Luchangling/T100/(list of files, cad)

Other CAD files:
dtu_app/doc/原理图/PCB外形图.dwg
