Luchangling/T100/dtu_app/doc/原理图/T103.pdf

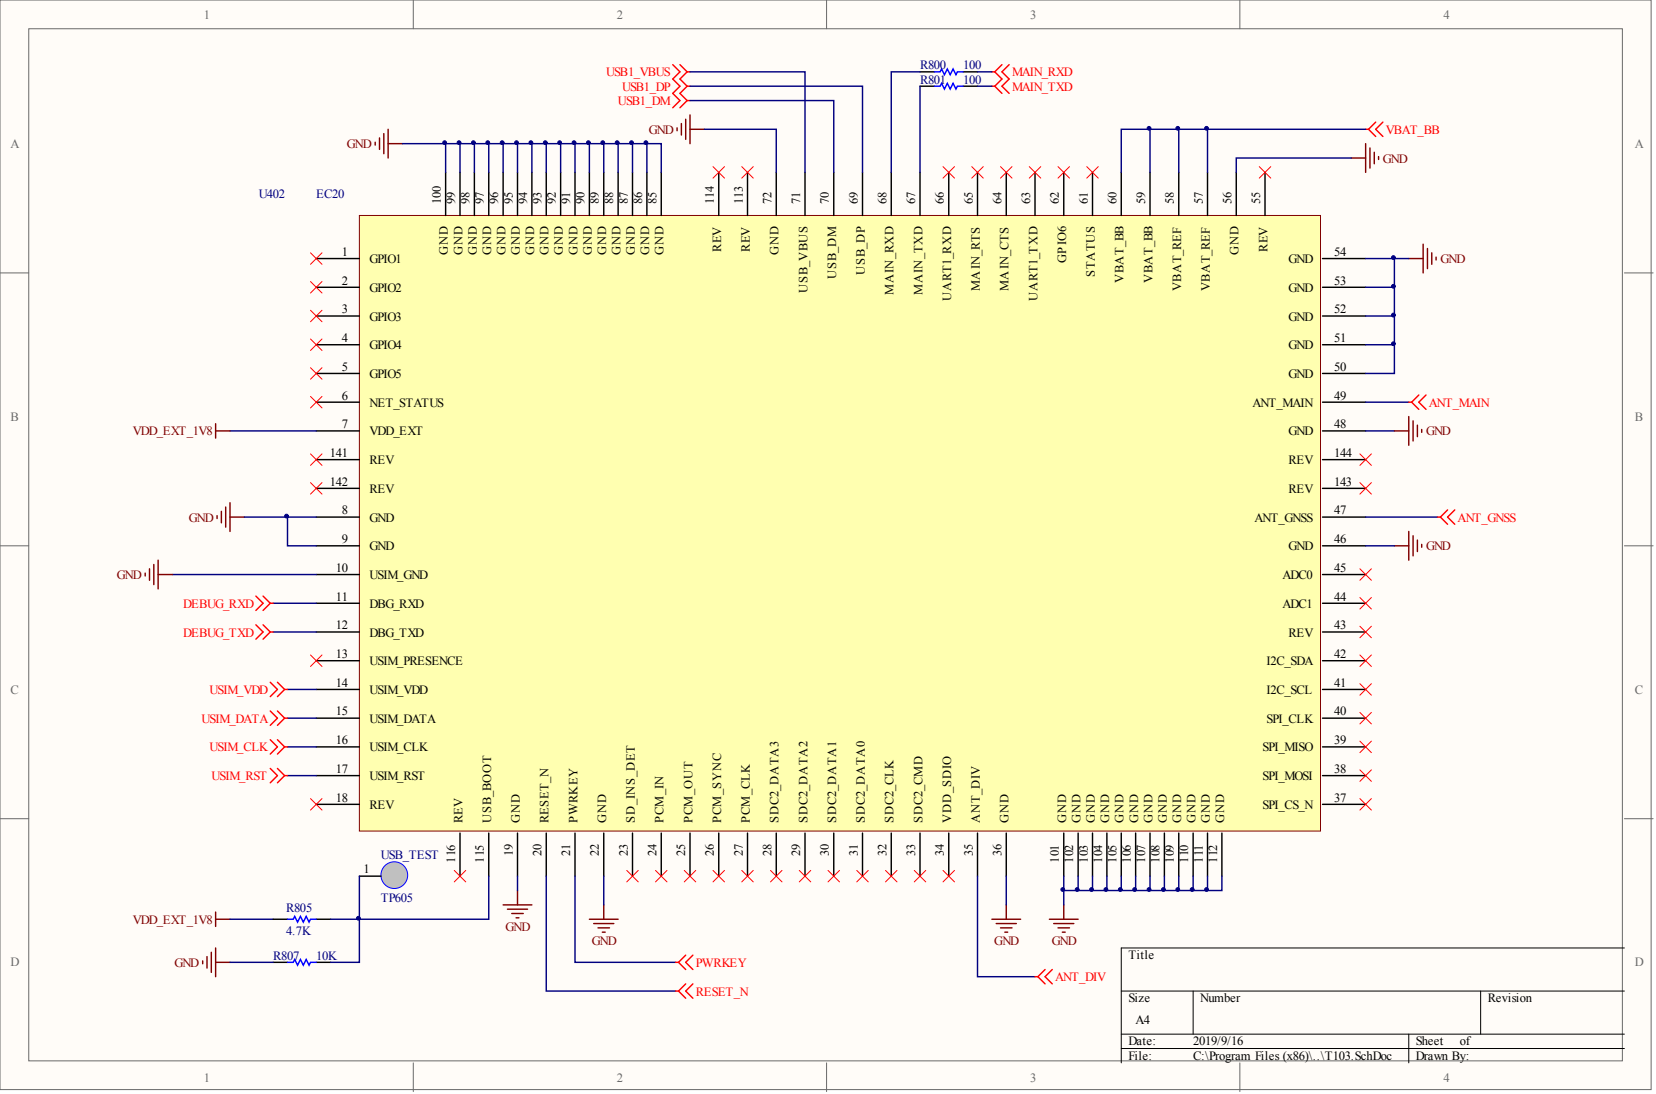
[picture p1: page 1]

GND 85 GND 86 GND 87 GND 88 GND 89 GND 90 GND 91 GND 92 GND 93 GND 94 GND 95 GND 96 GND 97 GND 98 GND 99 GND 100
