Luchangling/T100/dtu_app/doc/T100_V1.1_1128.pdf

A

1 | 2 | 3 | 4 | 5 | 6

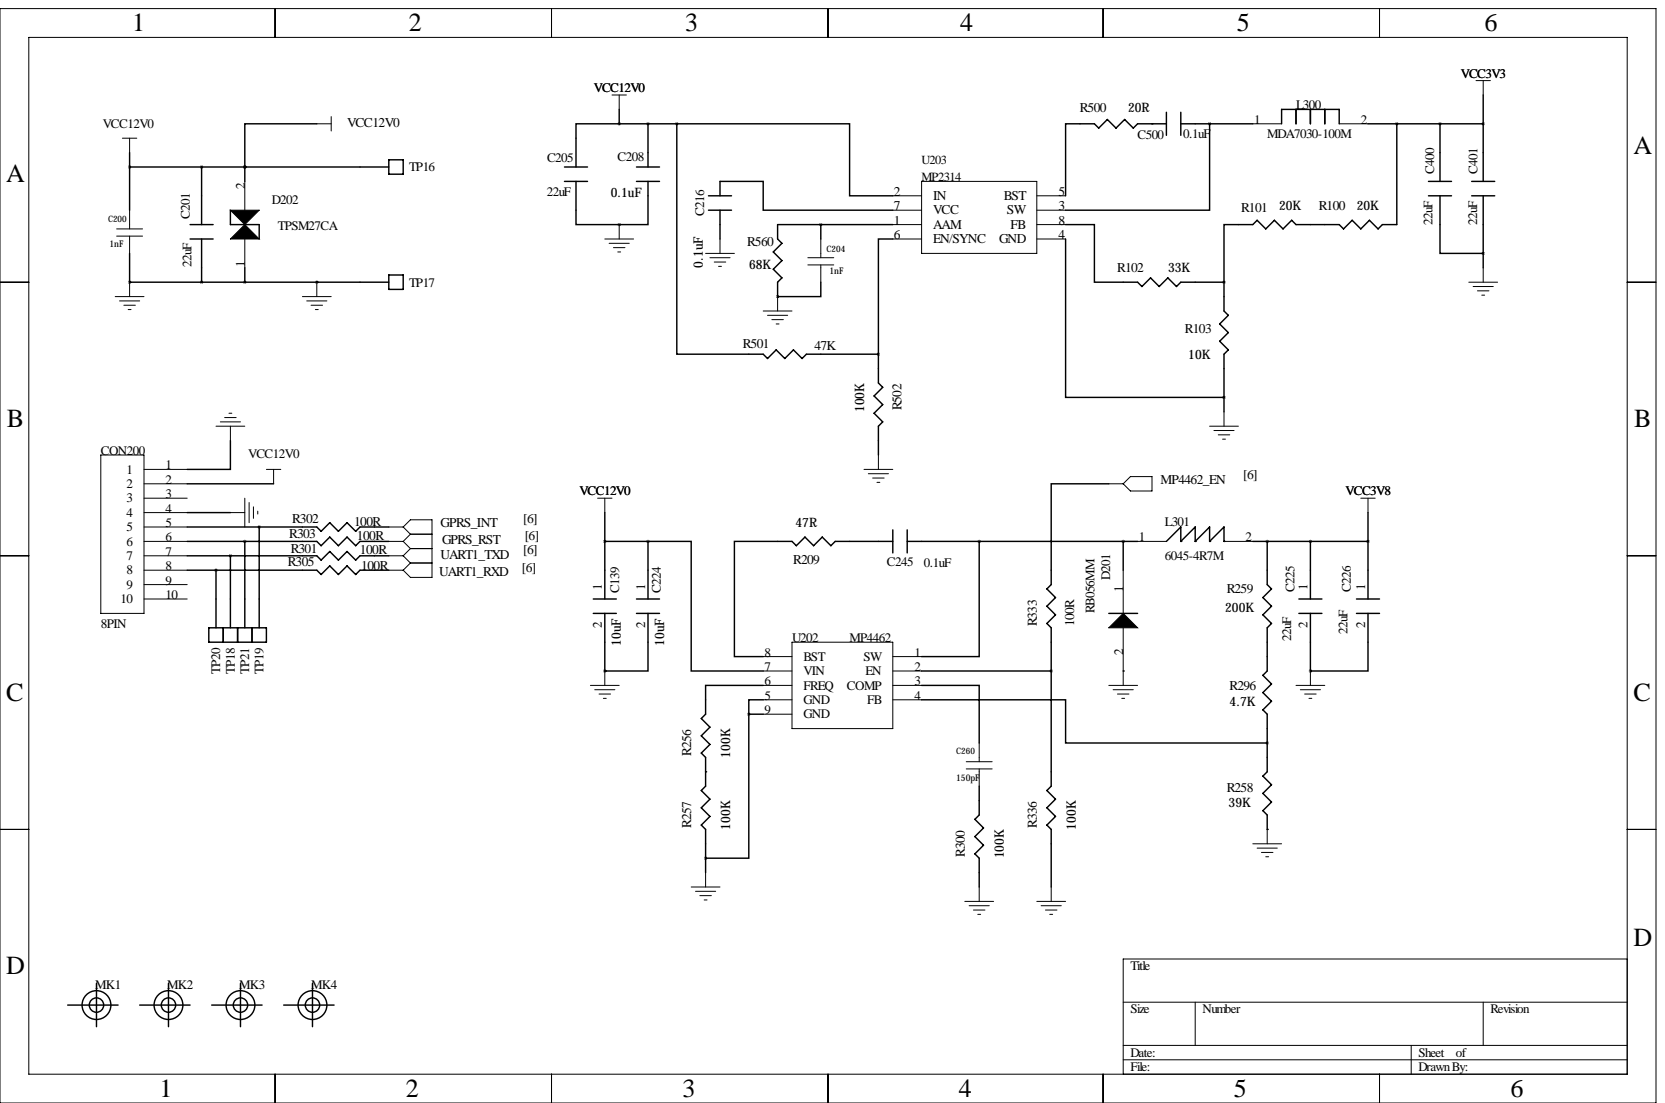
[picture p2: page 1]

Size | Number | Revision

Date: | Sheet of
File: | Drawn By:

A

A

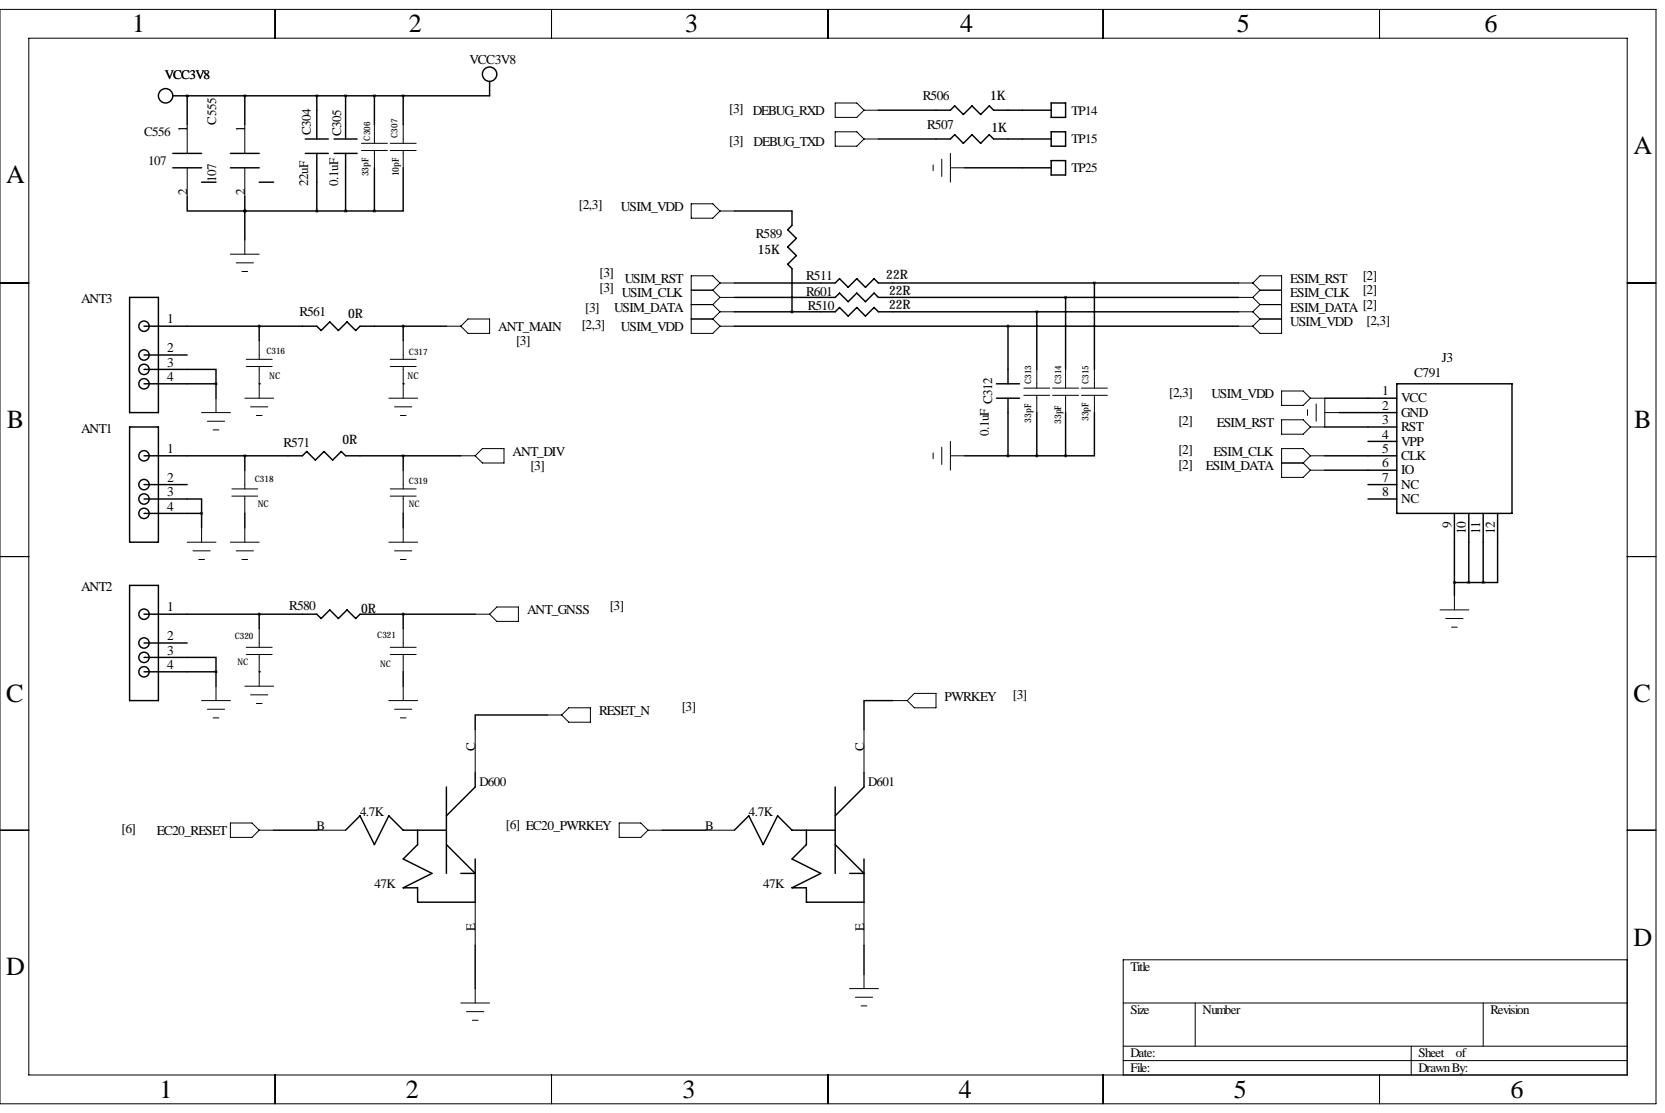
[picture p3: page 2]

Size | Number | Revision

Date: | Sheet of

A

A

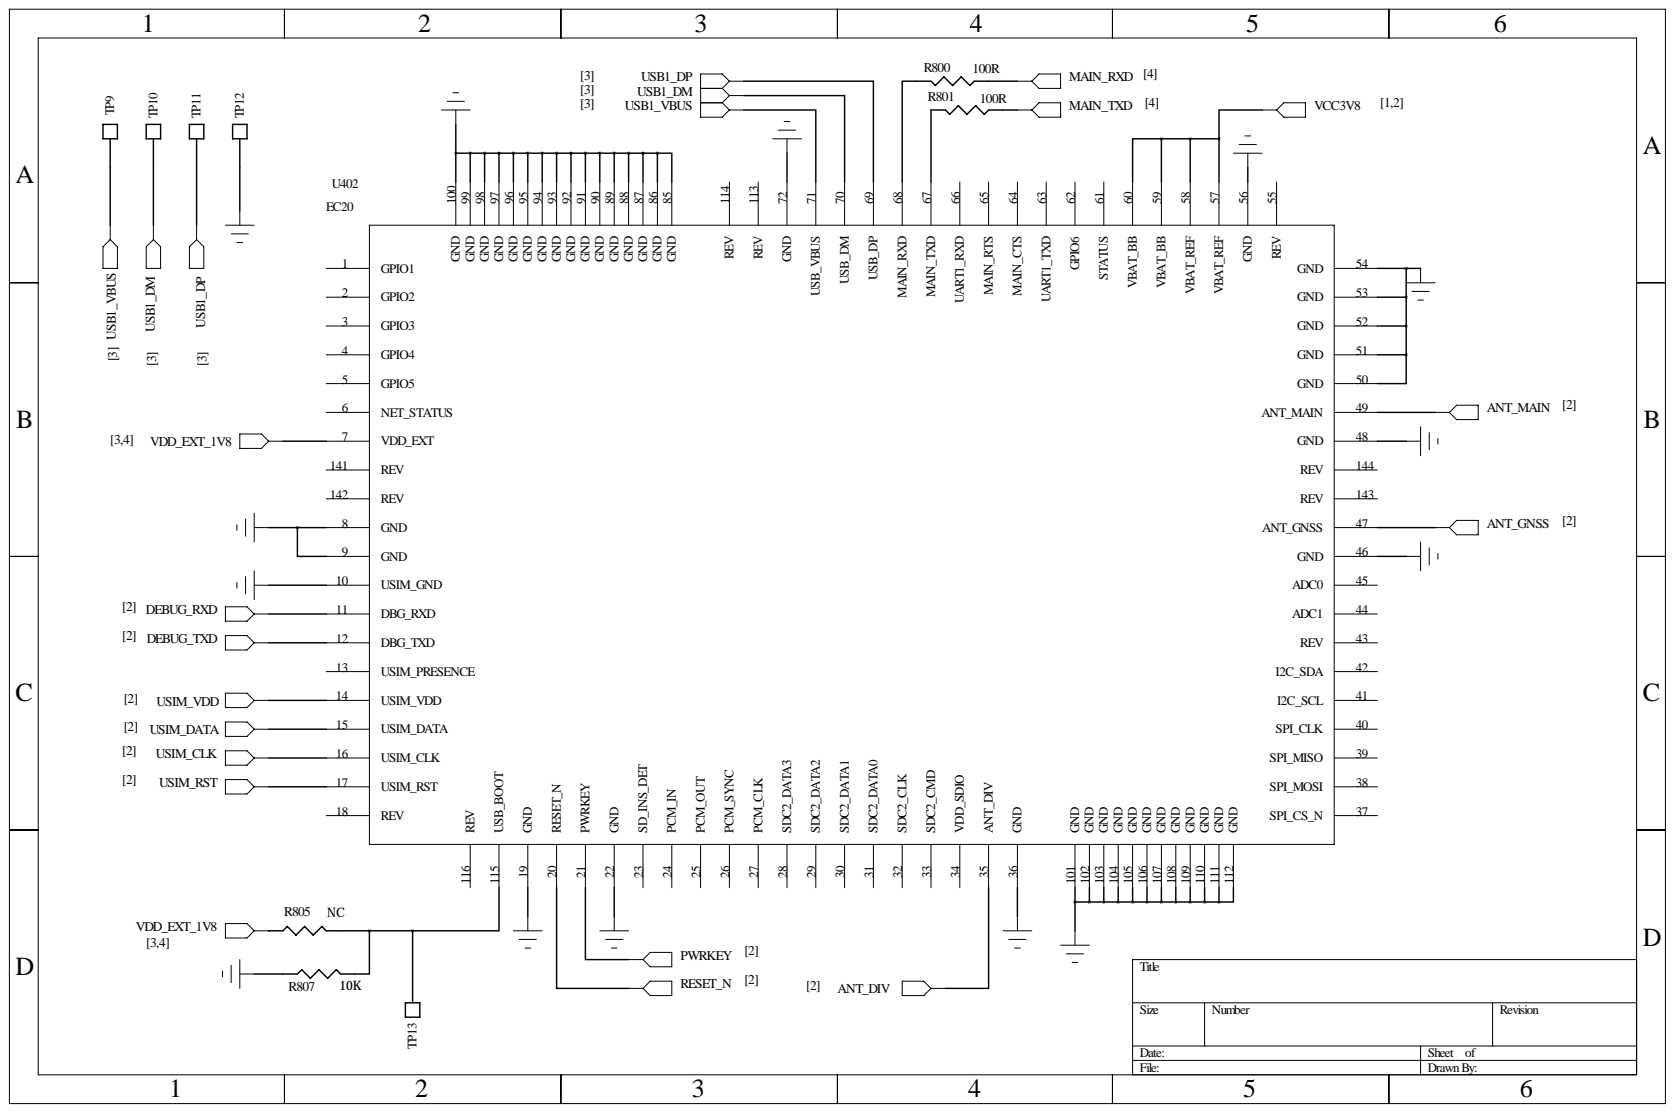
[picture p4: page 3]

Size | Number | Revision

Date: | Sheet of
File: | Drawn By:

A

A

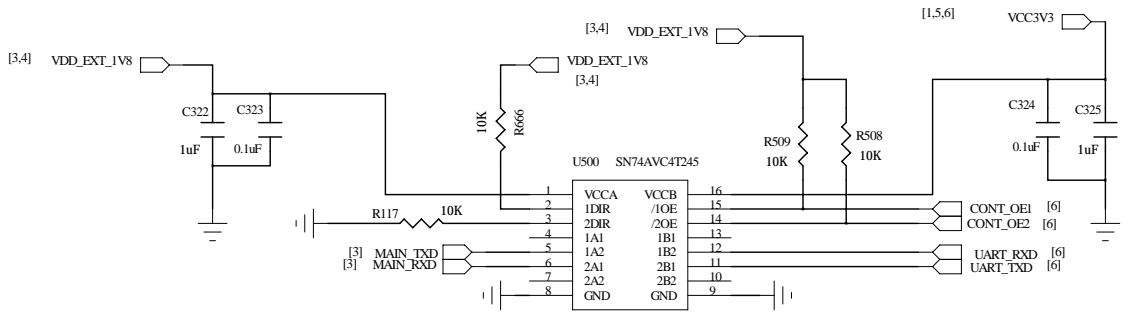
[picture p5: page 4]

Size | Number | Revision

Date: | Sheet of

A

A

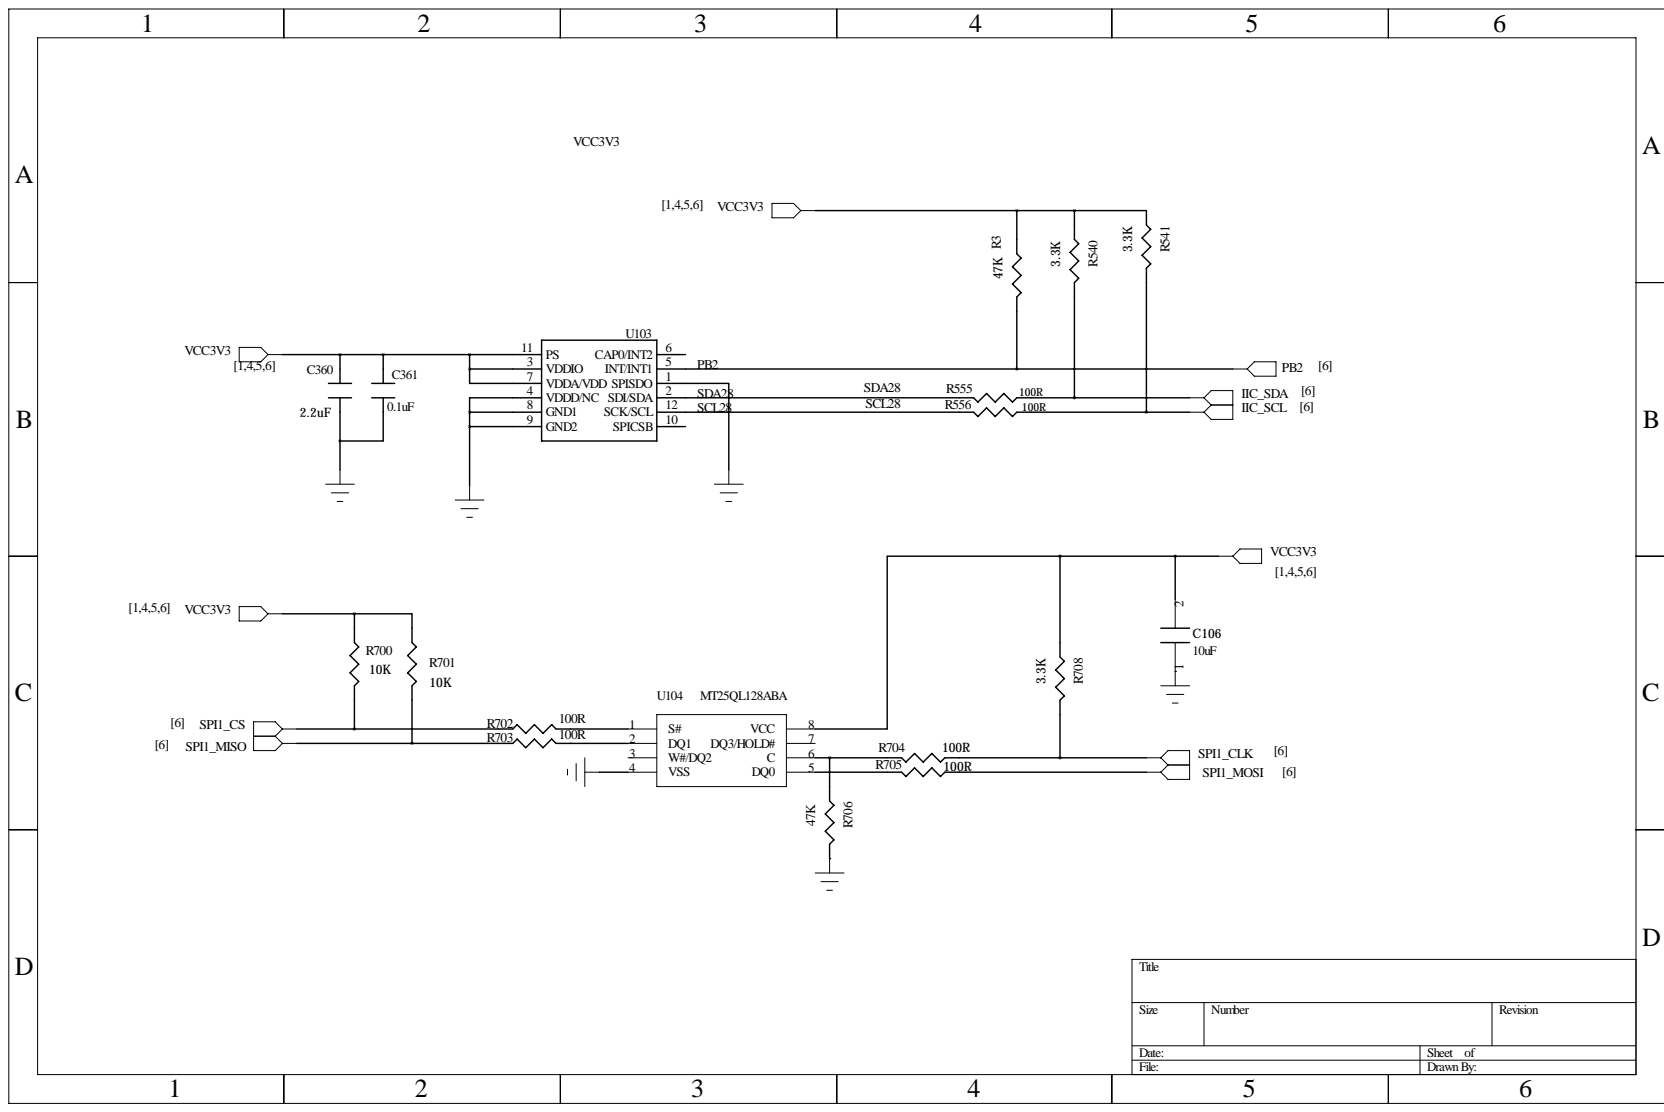
[picture p6: page 5]

Size | Number | Revision

Date: | Sheet of

A

A

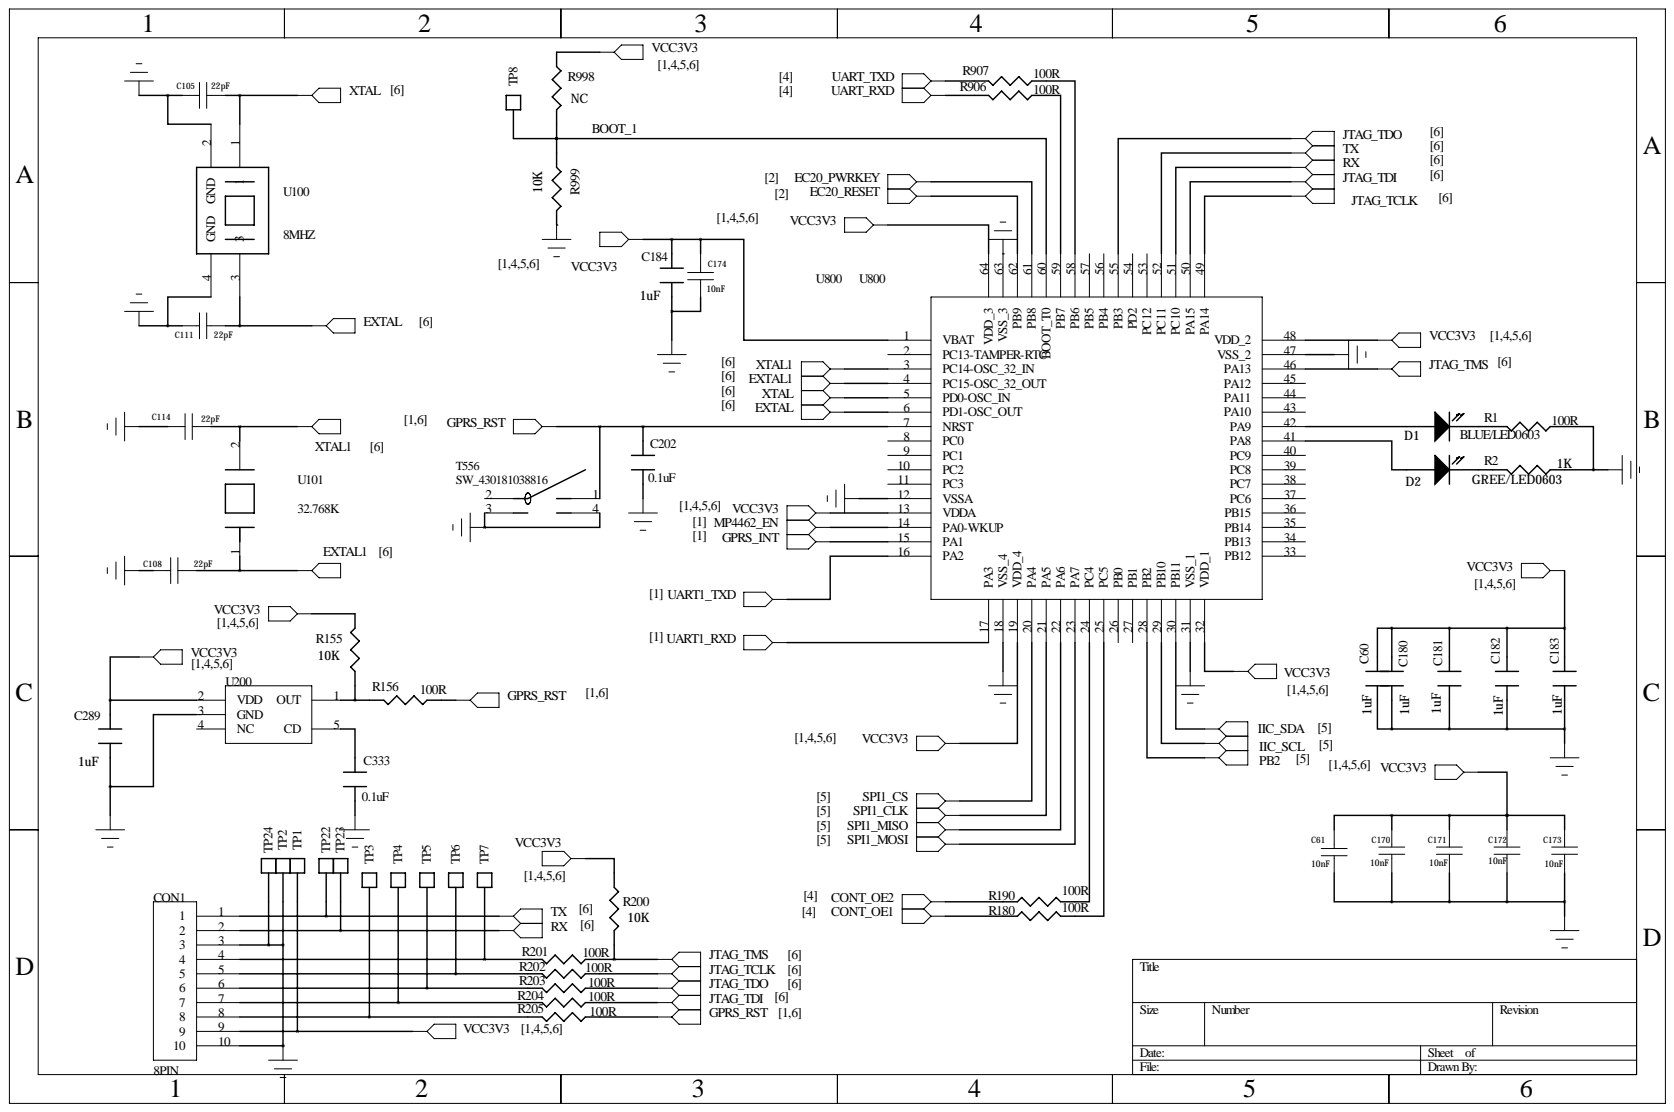
[picture p7: page 6]

Size | Number | Revision

Date: | Sheet of
