Luchangling/T100/dtu_app/doc/原理图/T101.pdf

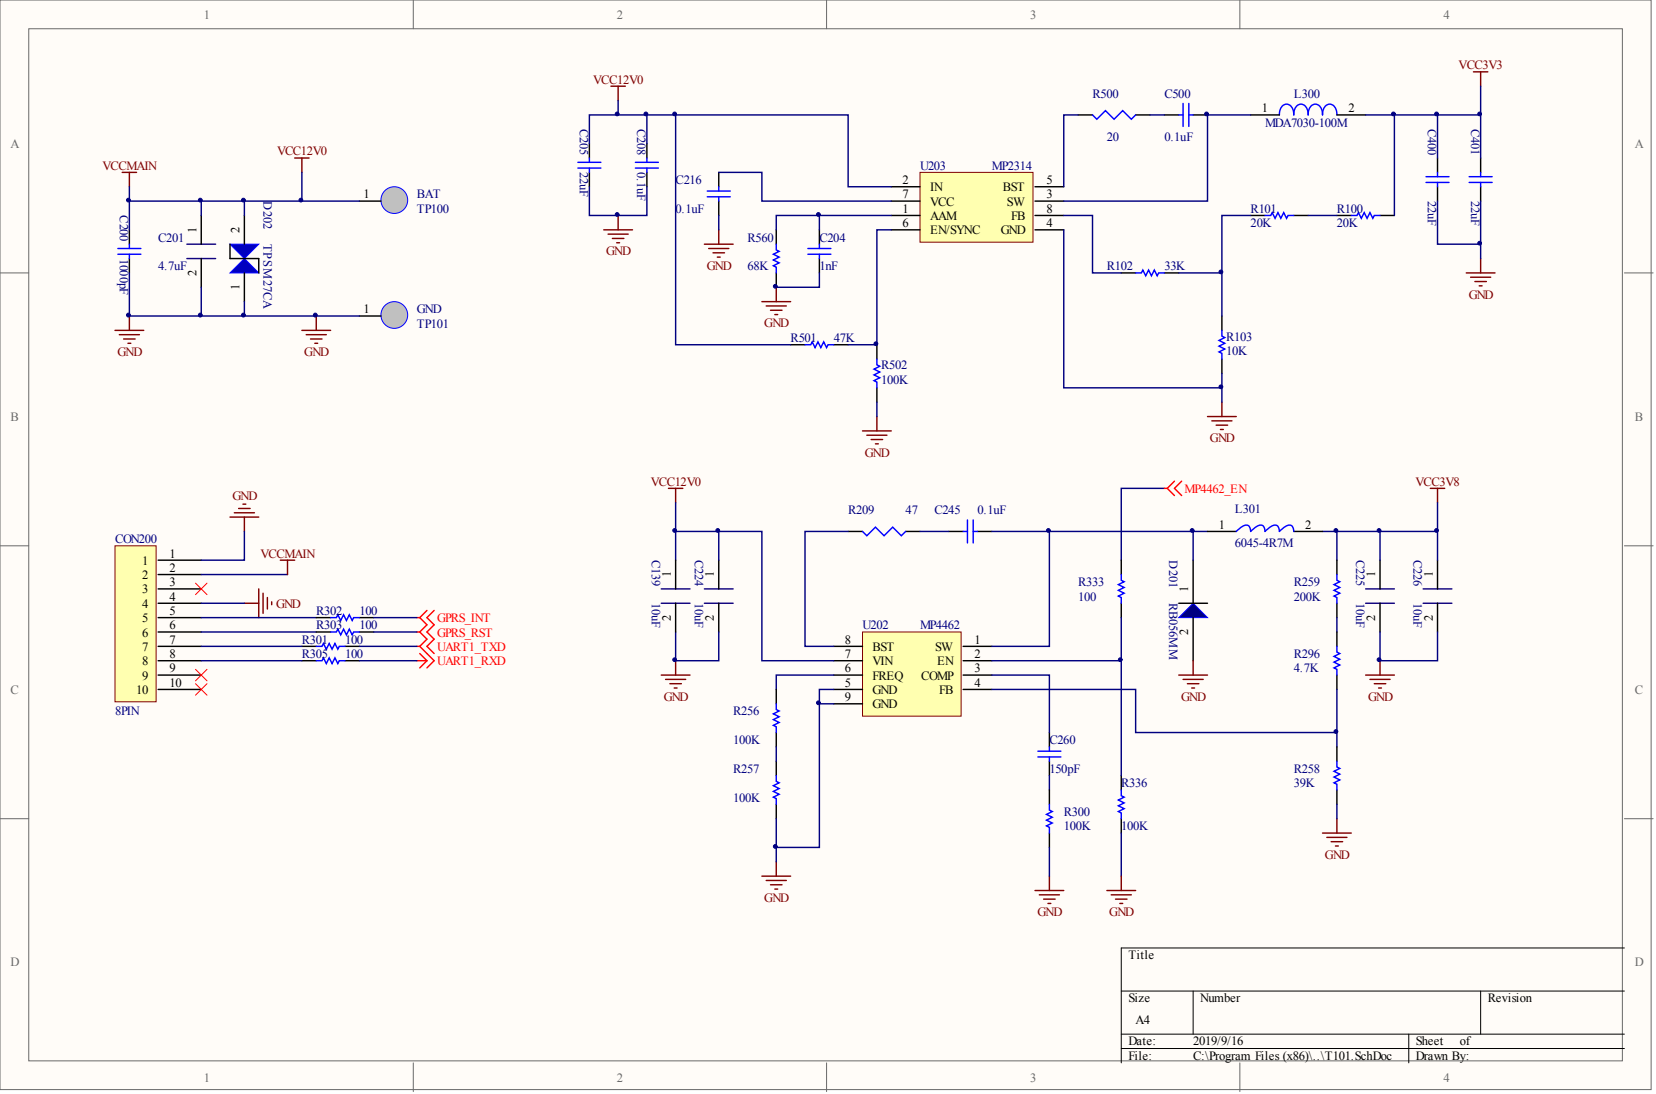
[picture p8: page 1]

VCC 7

EN/SYNC 6
