Luchangling/T100/dtu_app/doc/原理图/T102.pdf

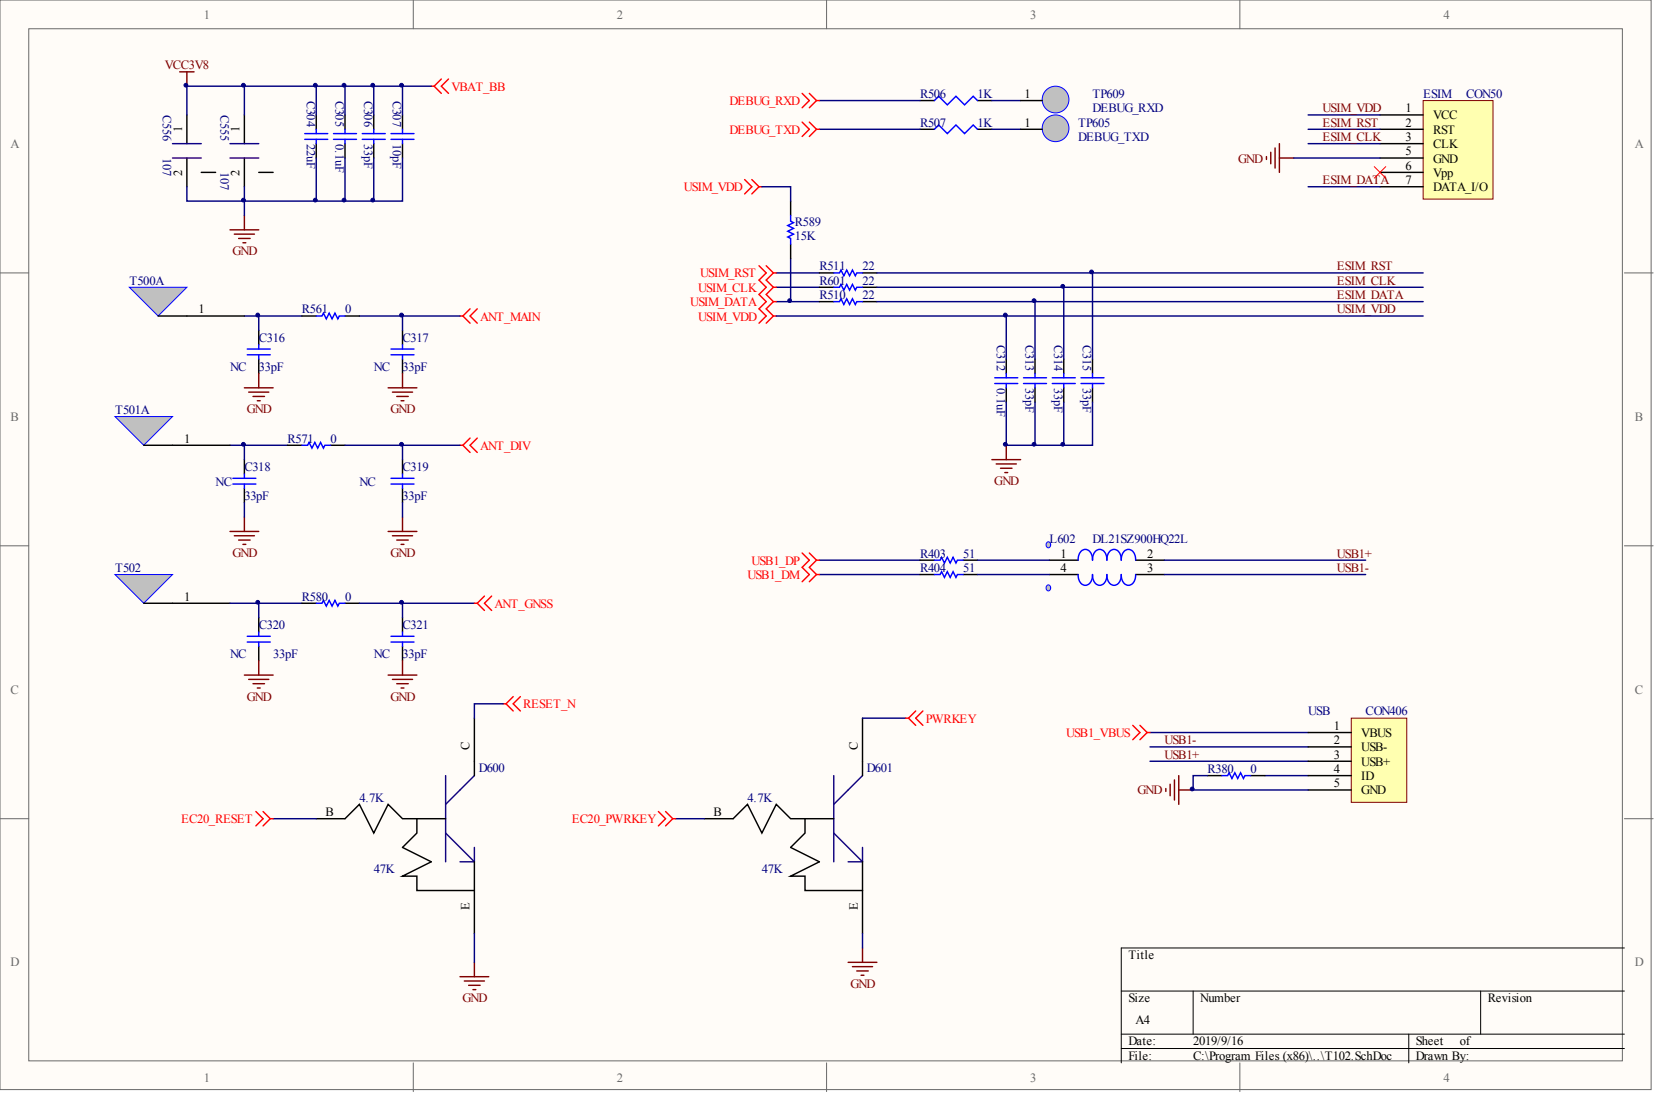
[picture p9: page 1]
