Luchangling/T100/dtu_app/doc/原理图/T104.pdf

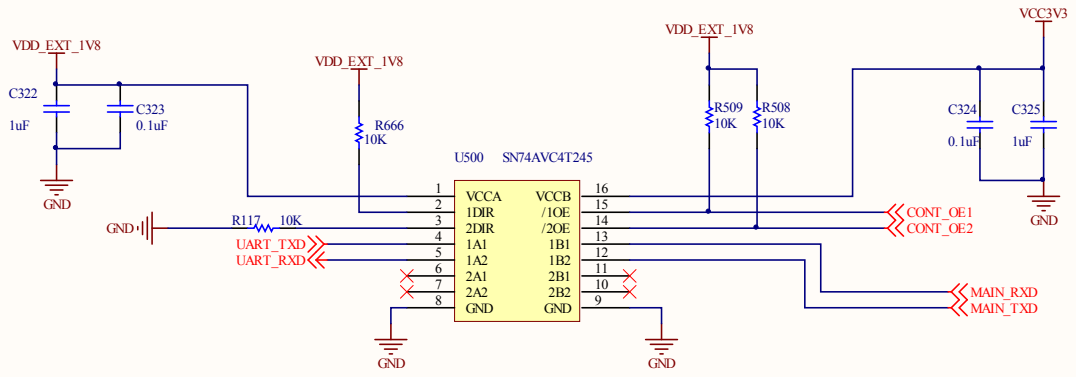
[picture p10: page 1]

1 2
1 1
