Luchangling/T100/dtu_app/doc/原理图/T105.pdf

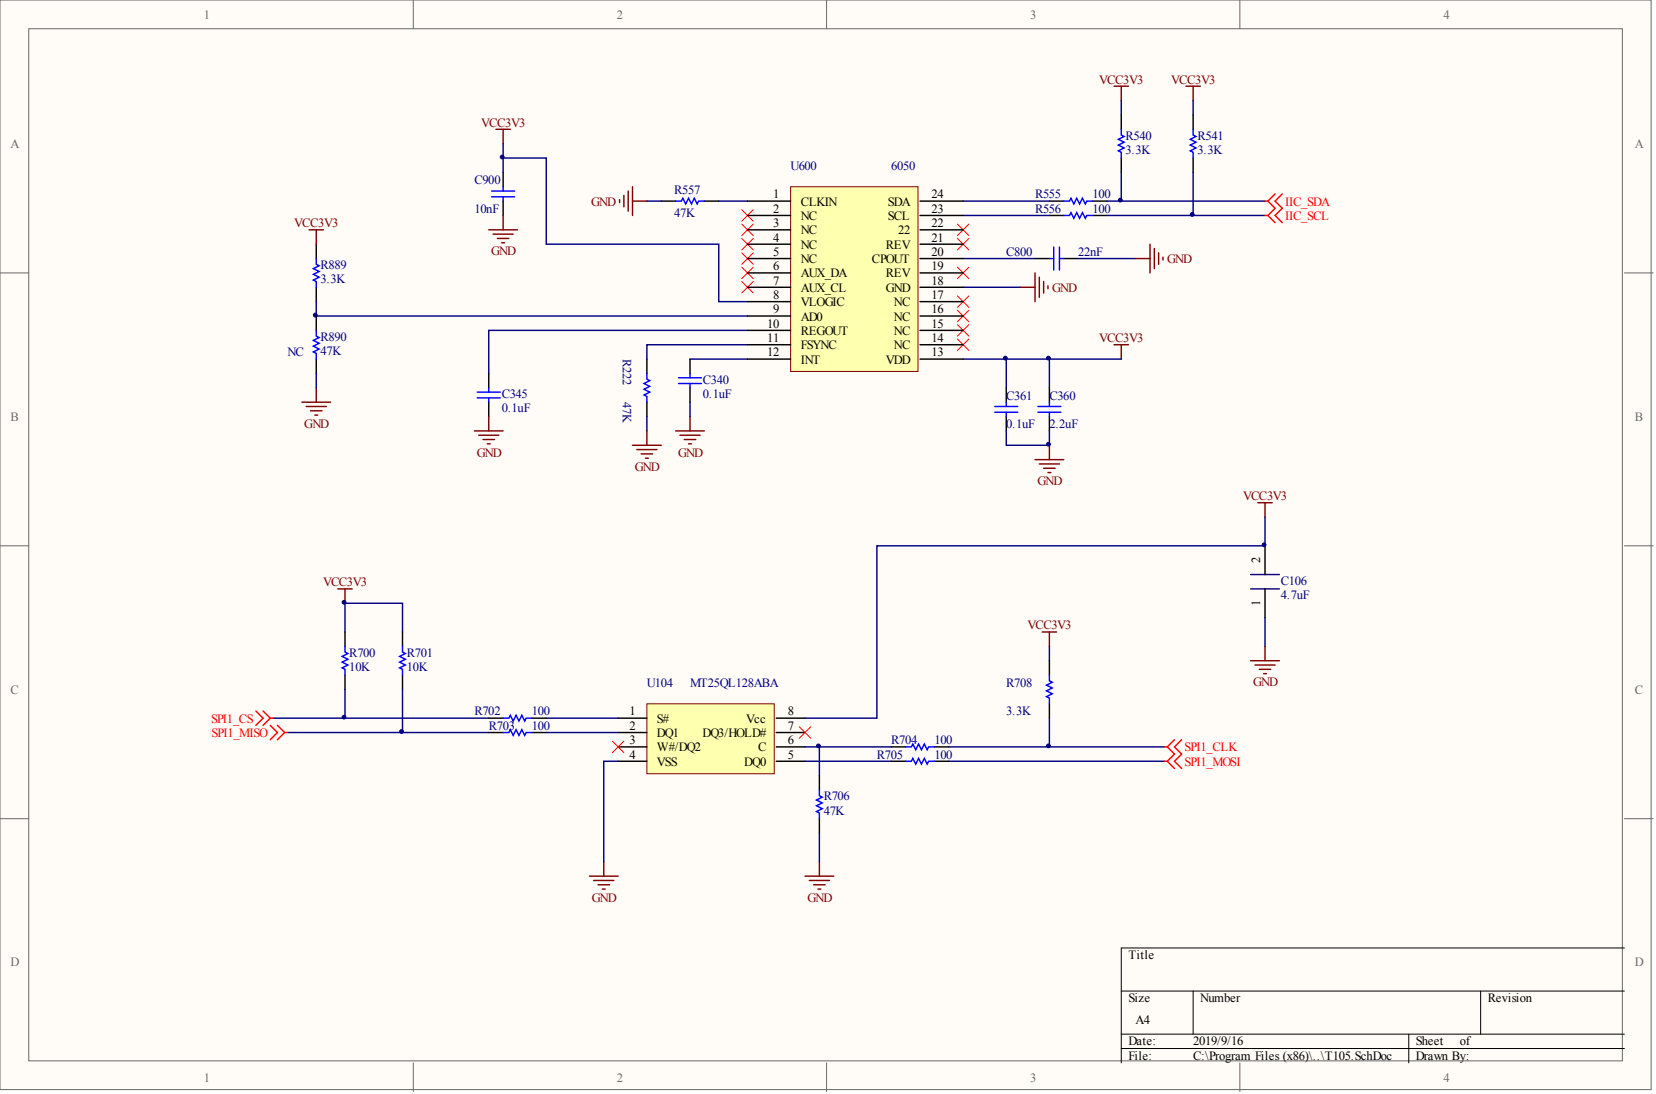
[picture p11: page 1]

FSYNC 11
