Luchangling/T100/dtu_app/doc/原理图/T106.pdf

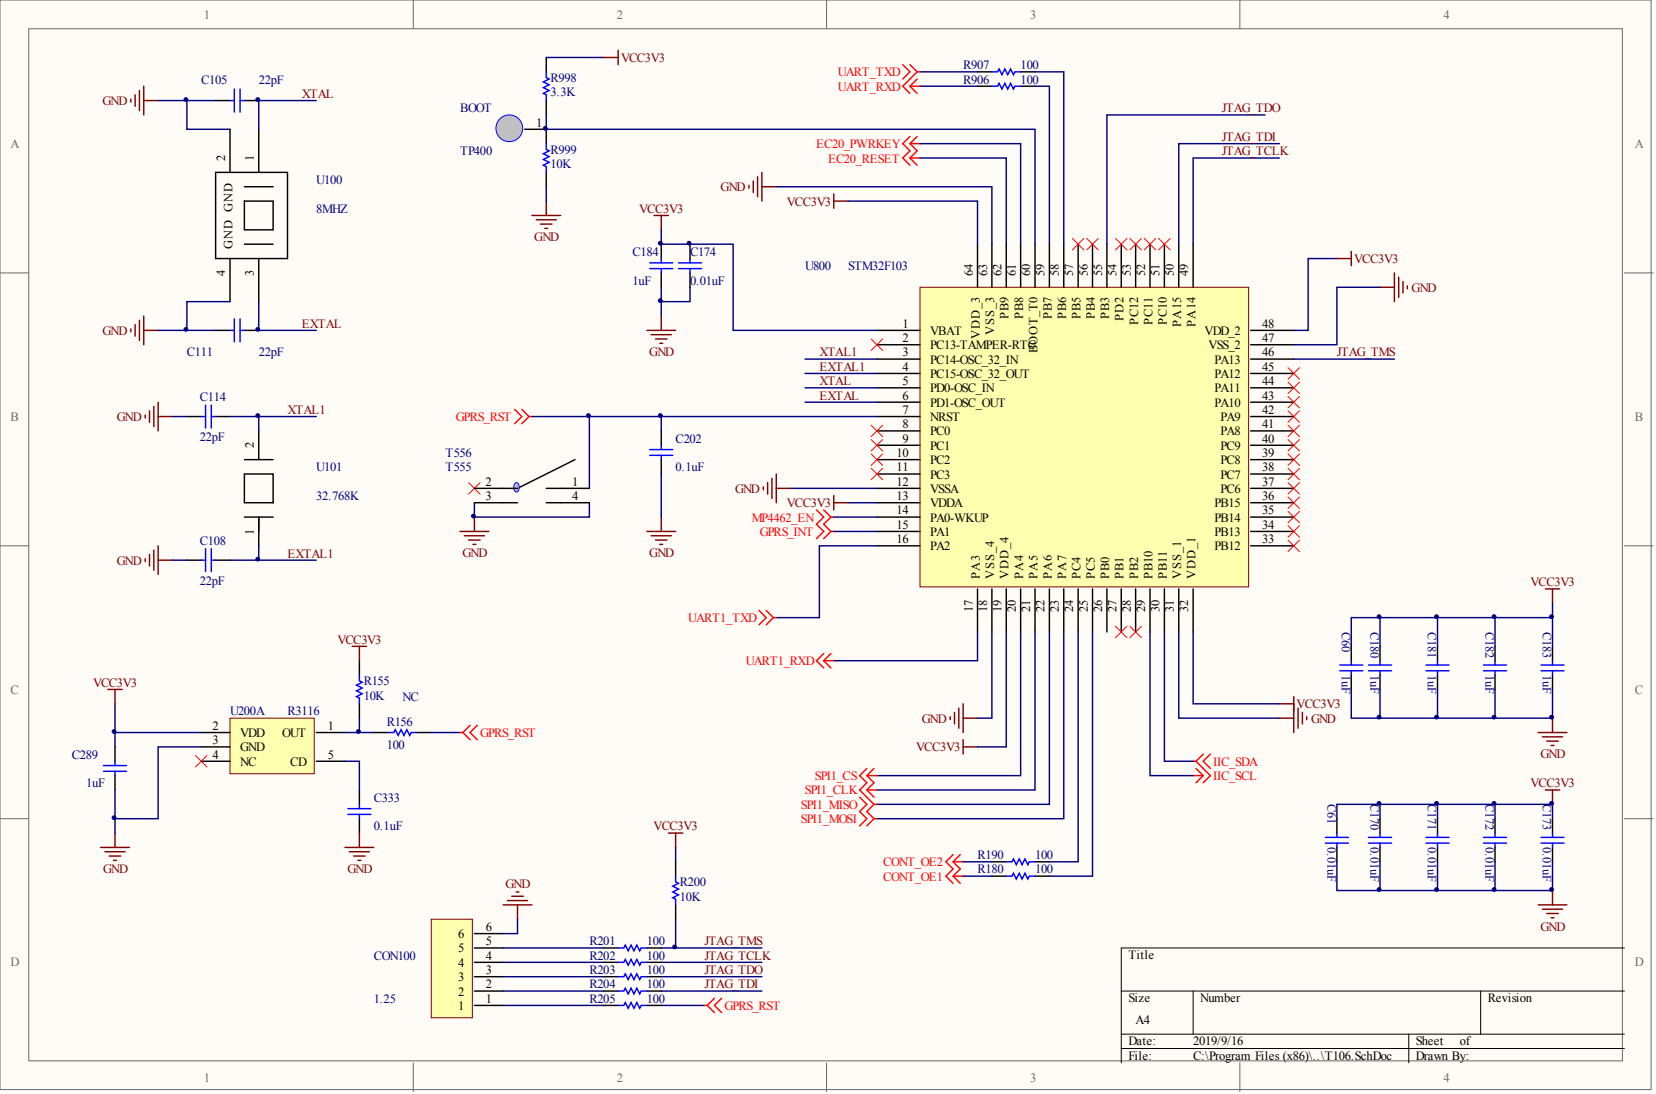
[picture p12: page 1]
