Luchangling/T100/dtu_app/doc/cl(1)/cl/t100/T101.pdf

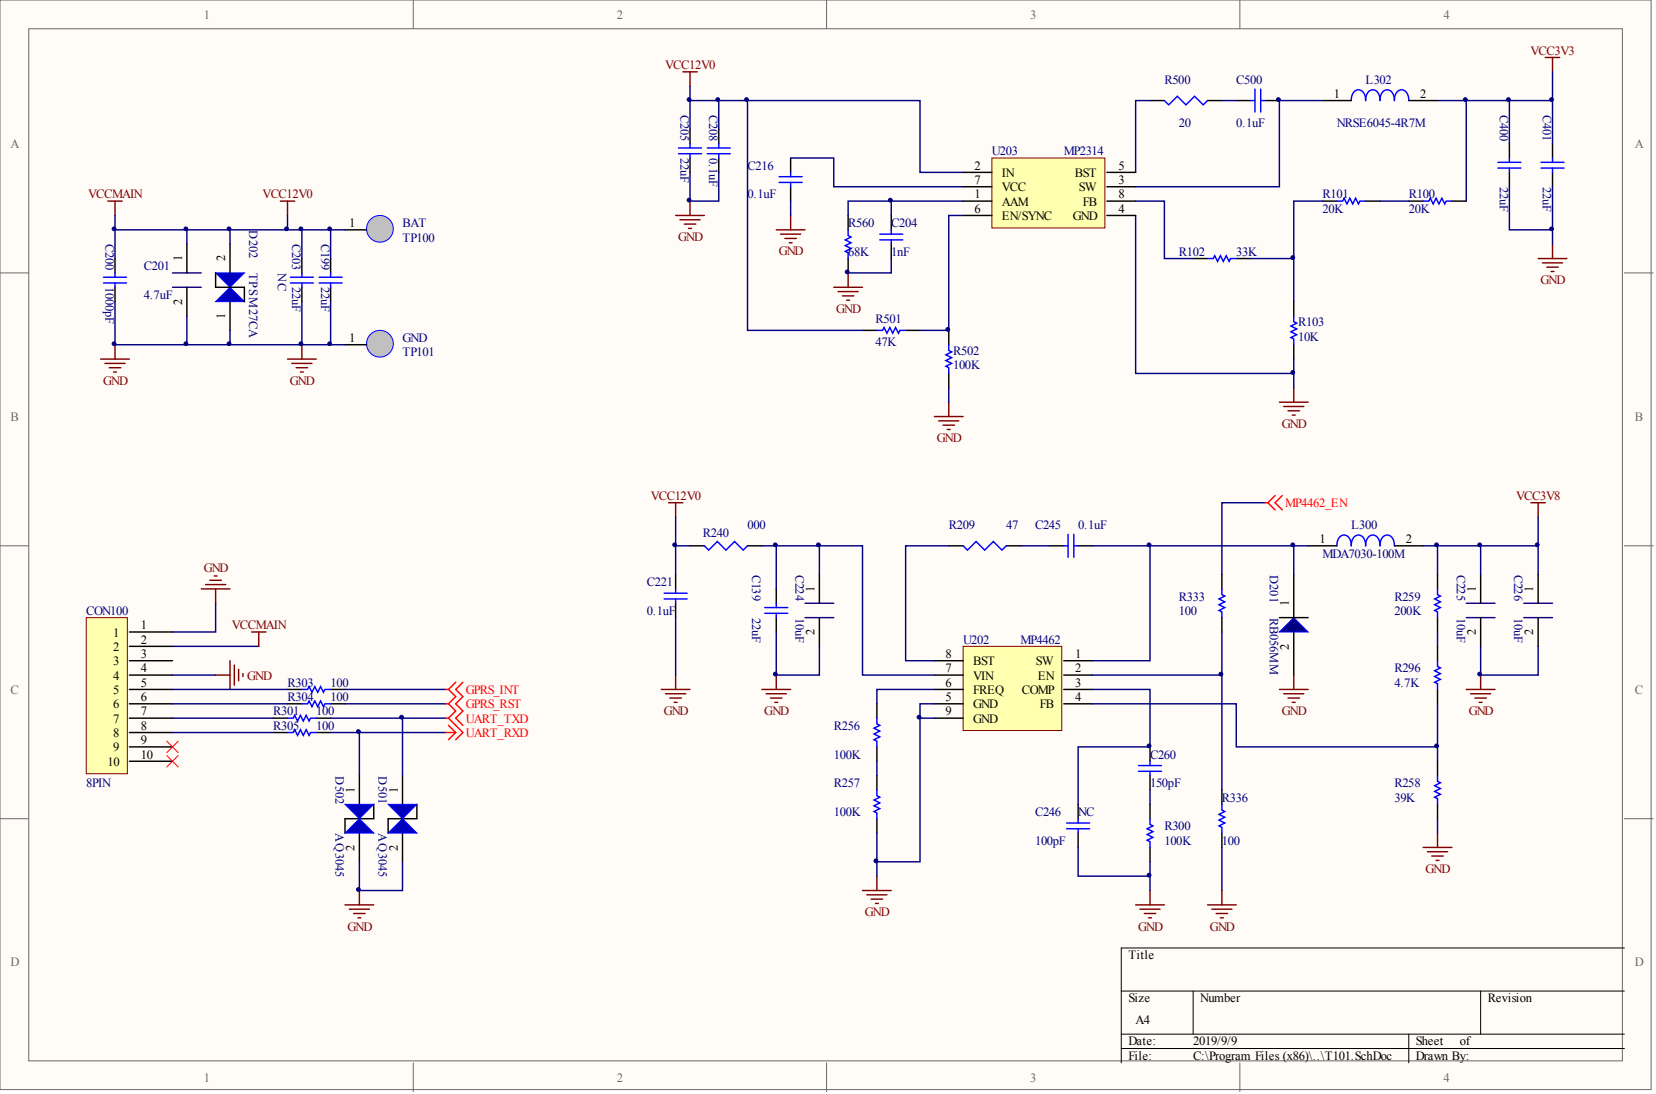
[picture p13: page 1]

VCC 7

EN/SYNC 6
