Luchangling/T100/dtu_app/doc/cl(1)/cl/t100/T102.pdf

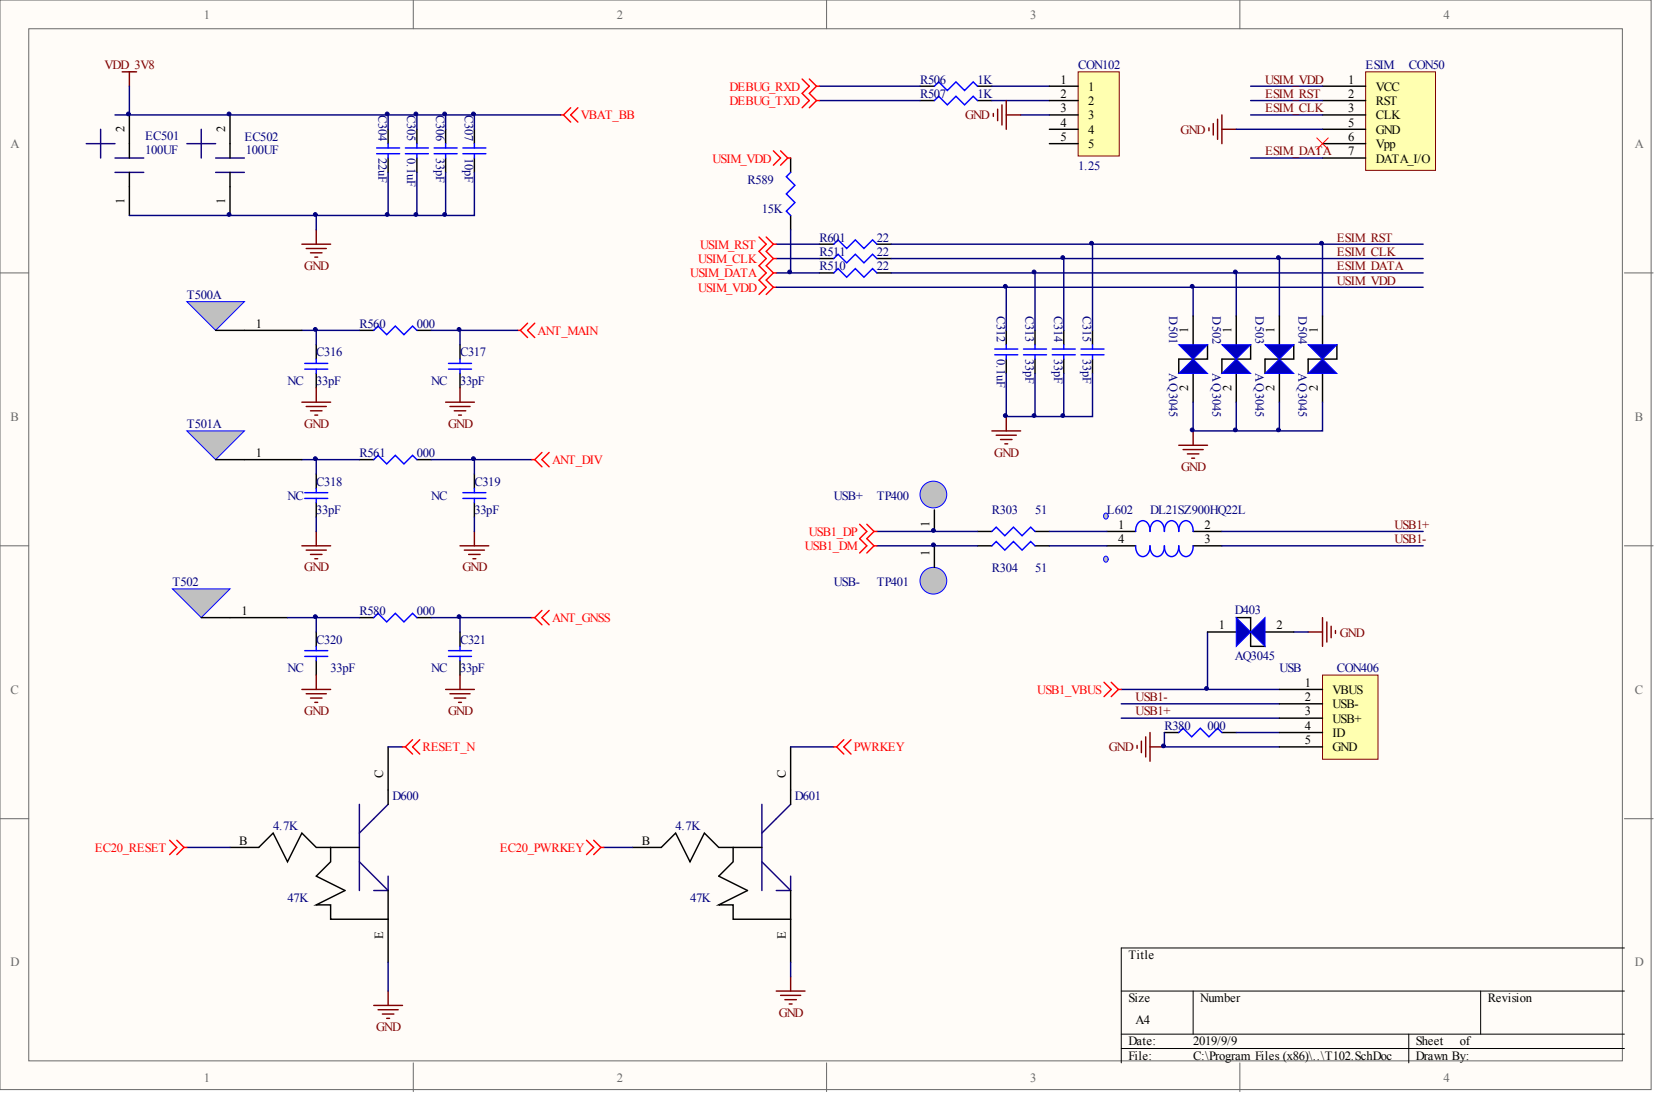
[picture p14: page 1]
