Luchangling/T100/dtu_app/doc/cl(1)/cl/t100/T104.pdf

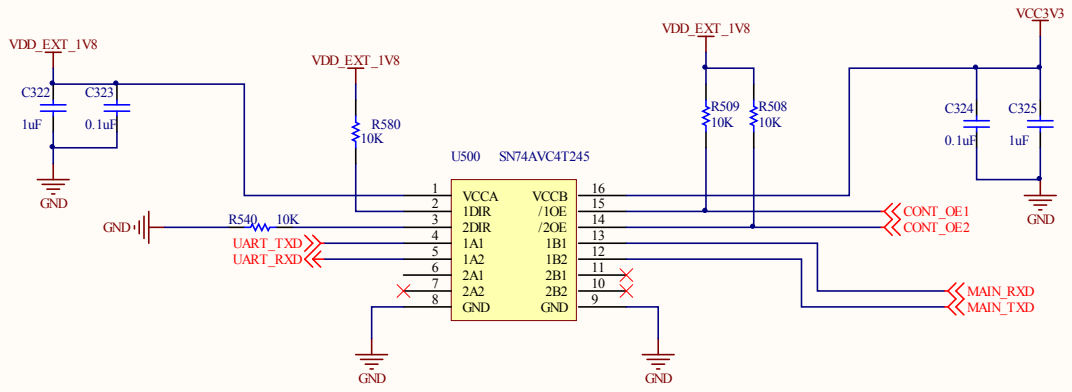
[picture p15: page 1]

1 2
1 1
