Luchangling/T100/dtu_app/doc/cl(1)/cl/t100/T105.pdf

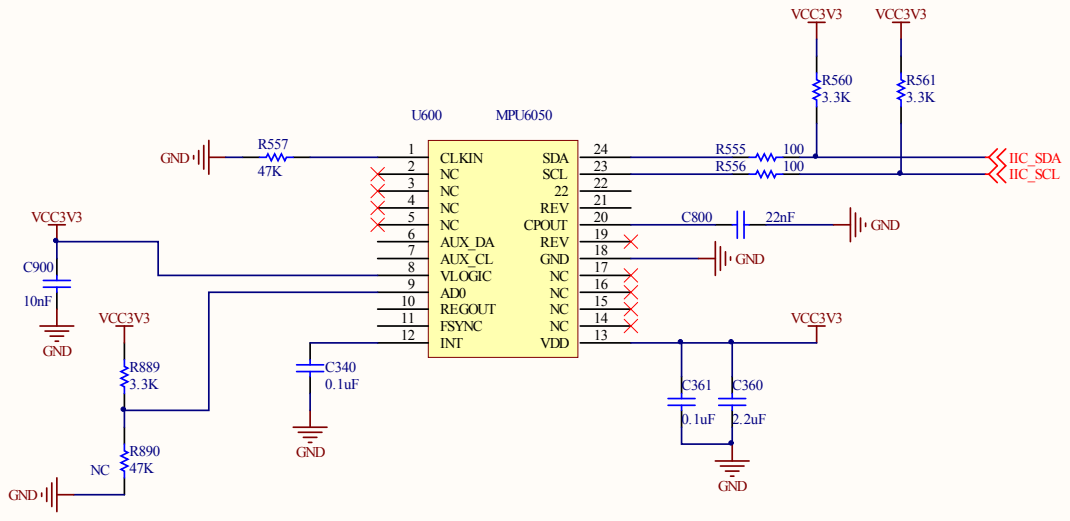
[picture p16: page 1]
