Luchangling/T100/dtu_app/doc/cl(1)/cl/t100/T106.pdf

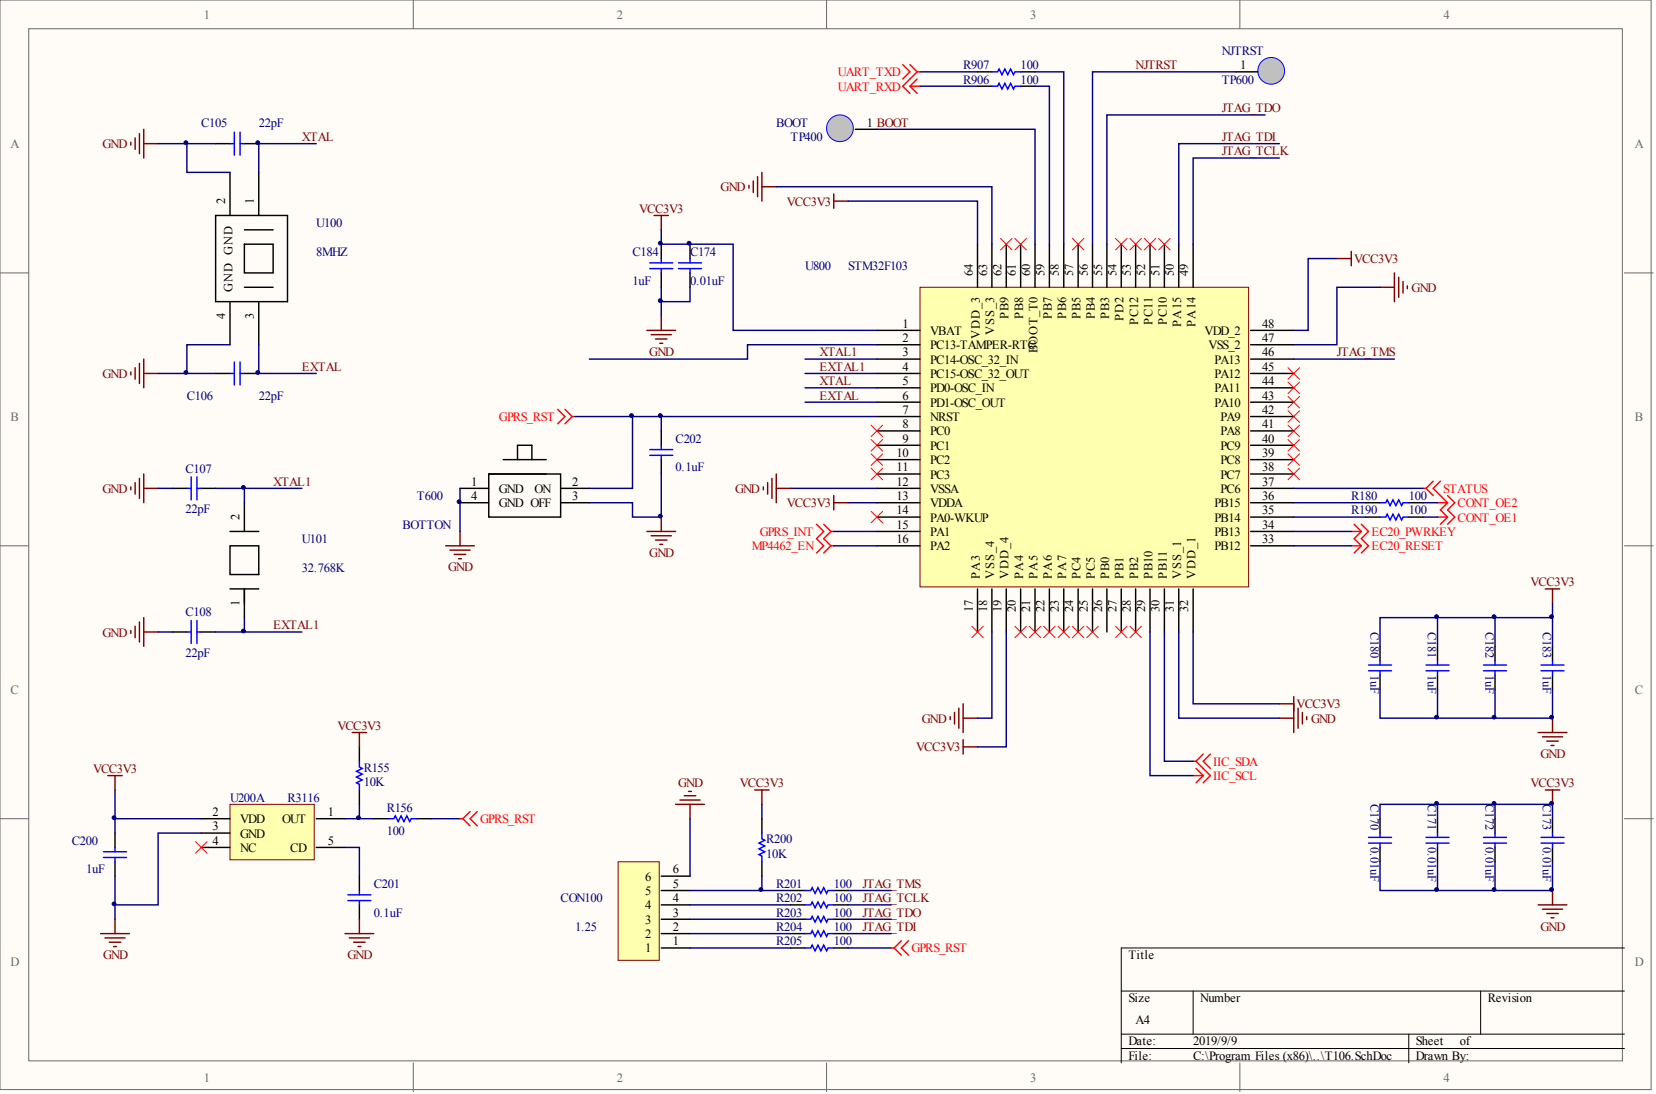
[picture p17: page 1]
