Luchangling/T100/dtu_app/bsp/timer/timer.c

#include "sys.h"
#include "timer.h"
#include "stm32f10x_tim.h"
#include "bsp.h"
//通用定时器3中断初始化
//这里时钟选择为APB1的2倍，而APB1为36M
//arr：自动重装值。
//psc：时钟预分频数
//这里使用的是定时器3!

static u32 s_sys_clock = 0;
static u32 s_setting_clock = 0;
static u32 s_base_time = 0;

void TIM3_Int_Init(void)
{
    TIM_TimeBaseInitTypeDef  TIM_TimeBaseStructure;
	NVIC_InitTypeDef NVIC_InitStructure;

    RCC_APB1PeriphClockCmd(RCC_APB1Periph_TIM3, ENABLE); //时钟使能

    TIM_DeInit(TIM3);
	
	//定时器TIM3初始化
	TIM_TimeBaseStructure.TIM_Period = 9999; //设置在下一个更新事件装入活动的自动重装载寄存器周期的值	
	TIM_TimeBaseStructure.TIM_Prescaler = 7199; //设置用来作为TIMx时钟频率除数的预分频值
	TIM_TimeBaseStructure.TIM_ClockDivision = TIM_CKD_DIV1; //设置时钟分割:TDTS = Tck_tim
	TIM_TimeBaseStructure.TIM_CounterMode = TIM_CounterMode_Up;  //TIM向上计数模式
	TIM_TimeBaseInit(TIM3, &TIM_TimeBaseStructure); //根据指定的参数初始化TIMx的时间基数单位
 
	TIM_ITConfig(TIM3,TIM_IT_Update,ENABLE ); //使能指定的TIM3中断,允许更新中断

	//中断优先级NVIC设置
	NVIC_InitStructure.NVIC_IRQChannel = TIM3_IRQn;  //TIM3中断
	NVIC_InitStructure.NVIC_IRQChannelPreemptionPriority = 0;  //先占优先级0级
	NVIC_InitStructure.NVIC_IRQChannelSubPriority = 3;  //从优先级3级
	NVIC_InitStructure.NVIC_IRQChannelCmd = ENABLE; //IRQ通道被使能
	NVIC_Init(&NVIC_InitStructure);  //初始化NVIC寄存器
    
    
	TIM_Cmd(TIM3, ENABLE);  //使能TIMx		

    s_sys_clock = 0;
}
//定时器3中断服务程序
void TIM3_IRQHandler(void)   //TIM3中断
{
	if (TIM_GetITStatus(TIM3, TIM_IT_Update) != RESET)  //检查TIM3更新中断发生与否
	{
	    TIM_ClearITPendingBit(TIM3, TIM_IT_Update  );  //清除TIMx更新中断标志 
	    s_sys_clock++;
        iwdg_feed();
	}
}


u32 clock(void)
{
    return s_sys_clock;
}


u32 util_clock(void)
{
    return s_sys_clock;
}


void set_local_time(u32 ticks)
{
    s_base_time = ticks;

    s_setting_clock = s_sys_clock;
}

u32 get_local_utc_sec(void)
{
    return (s_base_time + s_setting_clock - s_sys_clock);
}
