Luchangling/T100/dtu_app/app/file/stmflash.h

#ifndef __STMFLASH_H__
#define __STMFLASH_H__
#include "sys.h"  
#include "stm32f10x_flash.h"

//////////////////////////////////////////////////////////////////////////////////////////////////////
//用户根据自己的需要设置
#define STM32_FLASH_SIZE 256 	 		//所选STM32的FLASH容量大小(单位为K)
#define STM32_FLASH_WREN 1              //使能FLASH写入(0，不是能;1，使能)
//////////////////////////////////////////////////////////////////////////////////////////////////////

//从指定地址开始写入指定长度的数据
//WriteAddr:起始地址(此地址必须为2的倍数!!)
//pBuffer:数据指针
//NumToWrite:半字(16位)数(就是要写入的16位数据的个数.)
#if STM32_FLASH_SIZE<256
#define STM_SECTOR_SIZE 1024 //字节
#else 
#define STM_SECTOR_SIZE	2048
#endif


//FLASH起始地址
#define STM32_FLASH_BASE 0x08000000 	//STM32 FLASH的起始地址
//FLASH解锁键值
 

u16 STMFLASH_ReadHalfWord(u32 faddr);		  //读出半字  
void STMFLASH_WriteLenByte(u32 WriteAddr,u32 DataToWrite,u16 Len);	//指定地址开始写入指定长度的数据
u32 STMFLASH_ReadLenByte(u32 ReadAddr,u16 Len);						//指定地址开始读取指定长度数据
void STMFLASH_Write(u32 WriteAddr,u16 *pBuffer,u16 NumToWrite);		//从指定地址开始写入指定长度的数据
void STMFLASH_Read(u32 ReadAddr,u16 *pBuffer,u16 NumToRead);   		//从指定地址开始读出指定长度的数据
void STMFLASH_Write_NoCheck(u32 WriteAddr,u16 *pBuffer,u16 NumToWrite);


//测试写入
void Test_Write(u32 WriteAddr,u16 WriteData);								   
#endif
