Luchangling/T100/dtu_bootloader/bsp/inc/spi_flash_bsp.h

#ifndef __SPI_FLASH_BSP_H__
#define __SPI_FLASH_BSP_H__

#include "stm32f10x.h"
#include "stm32f10x_spi.h"
#include "w25x_spi_flash_reg.h"

#define FLASH_ID 0x6815

void spi_flash_init(void);


void SPI_Flash_Read(u8* pBuffer,u32 ReadAddr,u16 NumByteToRead);


void SPI_Flash_Write(u8* pBuffer,u32 WriteAddr,u16 NumByteToWrite);

u16 SPI_Flash_ReadID(void);//读取FLASH ID.  


#endif
